n07myn4m3/Electromiografo/README.md

WIKI  
-> https://n07myn4m3.github.io/  
PAPER  
-> https://www.overleaf.com/read/nbnqfxnxsdqp
