n07myn4m3/Electromiografo/paper-electromiografo/main.tex

\documentclass[oneside]{scrbook} 

\usepackage{siunitx}
\usepackage[spanish]{babel}
\usepackage[utf8]{inputenc}
\usepackage{amsmath}
\usepackage{amssymb}
\usepackage{graphicx}
\usepackage{float}
\usepackage{hyperref}
\usepackage{varioref}
\usepackage{fancyref}
\usepackage{cleveref}
\usepackage{pgfplots}
\usepackage{changepage}  
\usepackage{subcaption}
\usepackage{amsmath}
%-----------------------------------
\usepackage[backend=bibtex]{biblatex}
\addbibresource{electro.bib}

\title{Paper electromiografo} 

\author{Nicolás Ospina Mendivelso}

\date{\today} 

\begin{document} 
\maketitle 

\tableofcontents 
\listoffigures 
\listoftables 

\include{Contexto/Contexto} 
\include{Capitulo_1/Capitulo_1} 
\include{Caracterizacion/Caracterizacion}
\include{Capitulo_2/Capitulo_2}

\printbibliography

\end{document}
