n07myn4m3/Electromiografo/Info/listMaterials.md

# Pendiente
Lista de transistores que aun no se encuentran en las librerias  
* IRF7305  
* S12301
