n07myn4m3/Electromiografo/PCB/prototypeBoard/prototypeBoard.PDF

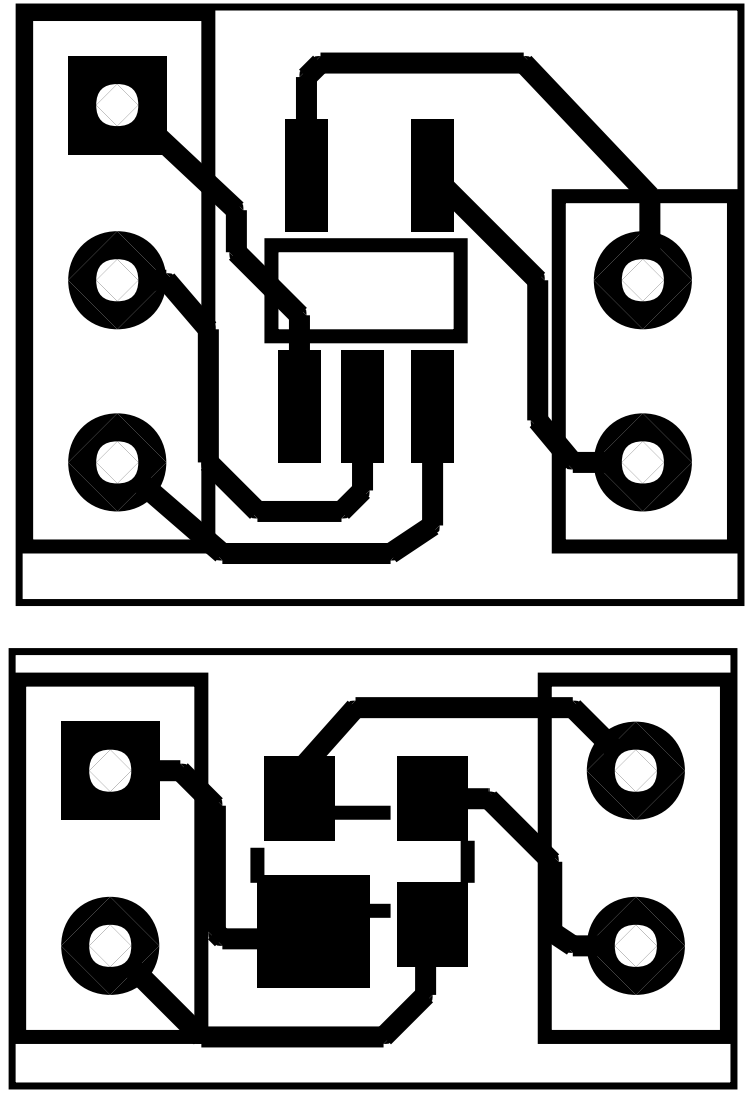
[picture p26: page 1]
