n07myn4m3/Electromiografo/Design/dif_bjt/simulacion.asc

C1: cap; 10µ
C2: cap; 10µ
Q1: npn; QS5W1
Q2: npn; QS5W1
Q3: npn; BCV61
Q4: npn; BCV61
R1: res; 15k
R2: res; 15k
R3: res; 24.9k
V1: voltage; 5
V2: voltage; 5
V3: voltage; SINE(0 0.01 1000 0 0 0)
V4: voltage; SINE(0 0.01 1000 0 0 180)
Named nets: 0, Vcc, Vee, Vin1, Vin2, Salida2, Salida1
.lib ../Componentes/BJT.txt
.tran 0 0.002 0
COMPONENTES
SIMULACION
ALIMENTACION
ENTRADAS
