n07myn4m3/Electromiografo/Design/dif_mosfet_actload/simulacion.asc

C1: cap; 1µf
M1: nmos; QS5K2
M2: nmos; QS5K2
Q1: pnp; BCV62
Q2: pnp; BCV62
Q3: npn; BCV61
Q4: npn; BCV61
R1: res; 10k
R2: res; 10k
R3: res; 30k
R4: res; 1k
V1: voltage; 5
V2: voltage; 5
V3: voltage; SINE(0 0.001 1000 0 0 0)
V4: voltage; SINE(0 0.001 1000 0 0 180)
Named nets: 0, Vcc, Vee, Vin1, Vin2
.lib ../Componentes/BJT.txt
.tran 0 0.01 0
.lib qs5k2.txt
COMPONENTES
SIMULACION
ALIMENTACION
ENTRADAS
