n07myn4m3/Electromiografo/Design/Drenador/Drenador.asc

R1: res; 100
R2: res; 100
U2: BCV61
V1: voltage; 5
Named nets: 0, Vcc
.lib ../Componentes/BCV61.lib
.tran 0.01
