n07myn4m3/Electromiografo/Design/Emiter_follower_ind/Emiter_follower_ind.asc

C1: cap; 10µ
Q1: npn; 2N3904
Q2: npn; BCV61
Q5: npn; BCV61
R3: res; 20.87k
R9: res; 1Meg
V1: voltage; 5
V2: voltage; 5
V3: voltage; SINE(0 0.015 1000 0 0 0); AC 0.015 0
Named nets: 0, Vcc, Vee, Vin1, Salida
.lib ../Componentes/BJT.txt
COMPONENTES
SIMULACION
ALIMENTACION
ENTRADAS
.tran 0 0.002 0
