n07myn4m3/Electromiografo/Design/espejo/seguidor.asc

M1: nmos; IRF7303
R3: res; 1k
V1: voltage; 5
V2: voltage; 5
V3: voltage; SINE(0 0.01 1000 0 0 0)
Named nets: 0, Vcc, Vee
.tran 0 0.01 0
.lib ../Componentes/MOSFET.txt
