n07myn4m3/Electromiografo/Design/espejo/simulacion DC.asc

I1: current; 300µ
Q1: npn; QS5W2
Q2: npn; QS5W2
Q3: npn; BCV61
Q4: npn; BCV61
R1: res; 32k
R2: res; 32k
V1: voltage; 5
V2: voltage; 5
Named nets: 0, Vcc, Vee
.lib ../Componentes/ BJT.txt
.tran 0 0.01 0
