n07myn4m3/Electromiografo/Design/espejo/simulacion.asc

Q3: npn; BCV61
Q4: npn; BCV61
R2: res; 20k
R3: res; 24.2k
V1: voltage; 5
V2: voltage; 5
Named nets: 0, Vcc, Vee
.lib ../Componentes/BJT.txt
.tran 0 0.01 0
COMPONENTES
SIMULACION
ALIMENTACION
