n07myn4m3/Electromiografo/Design/dif_mosfet/simulacion.asc

C1: cap; 22µf
M1: nmos; QS5K2
M2: nmos; QS5K2
Q3: npn; BCV61
Q4: npn; BCV61
R1: res; 15k
R2: res; 15k
R3: res; 24.2k
R4: res; 1Meg
V1: voltage; 5
V2: voltage; 5
V3: voltage; SINE(0 0.015 1000 0 0 0)
V4: voltage; SINE(0 0.015 1000 0 0 180)
Named nets: 0, Vcc, Vee, Vin1, Vin2, Salida
.lib ../Componentes/BJT.txt
.tran 0 0.002 0
.lib qs5k2.txt
COMPONENTES
SIMULACION
ALIMENTACION
ENTRADAS
