n07myn4m3/Electromiografo/Design/dif_bjt_actload/bjt_act_load.asc

C1: cap; 22µ
C2: cap; 22µ
C3: cap; 22µ
Q1: npn; QS5W1
Q2: npn; QS5W1
Q3: npn; BCV61
Q4: npn; BCV61
Q5: pnp; BCV62
Q6: pnp; BCV62
R1: res; 3MEG
R2: res; 7MEG
R3: res; 32k
R4: res; 3Meg
R5: res; 7MEG
V1: voltage; 5
V2: voltage; 5
V3: voltage; SINE(0 0.01 1000 0 0 0)
V4: voltage; SINE(0 0.01 1000 0 0 180)
Named nets: 0, Vcc, Vee, Vin1, Vin2
.lib ../Componentes/BJT.txt
.tran 0 0.01 0
COMPONENTES
SIMULACION
ALIMENTACION
ENTRADAS
