n07myn4m3/Electromiografo/Design/Emiter_follower/Emiter_follower.asc

C1: cap; 20n
M1: nmos; QS5K2
M2: nmos; QS5K2
Q1: npn; 2N3904
Q2: npn; BCV61
Q3: npn; BCV61
Q4: npn; BCV61
Q5: npn; BCV61
R1: res; 50k
R2: res; 50k
R3: res; 50k
R4: res; 100k
R5: res; 100k
R7: res; 32k
R8: res; 1Meg
R9: res; 1Meg
V1: voltage; 5
V2: voltage; 5
V3: voltage; SINE(0 0.015 1000 0 0 0); AC 0.015 0
V4: voltage; SINE(0 0.015 1000 0 0 180); AC 0.015 180
Named nets: 0, Vcc, Vee, Vin1, Vin2
.lib ../Componentes/BJT.txt
.lib qs5k2.txt
COMPONENTES
SIMULACION
ALIMENTACION
ENTRADAS
;tran 0 0.002 0
.ac oct 10 0.002 5k
