n07myn4m3/Electromiografo/Design/LTspice/Fuente.asc

R1: res; 100
R2: res; 100
U1: BCV62
V1: voltage; 5
Named nets: 0, Vcc
.lib BCV62.lib
.tran 0.01
