n07myn4m3/Electromiografo/Design/Caracterizacion/QS5K2/simulacion.asc

M1: nmos; QS5K2
R1: res; 15k
V1: voltage; 5
V2: voltage; SINE(0 0.015 1000 0 0 180)
Named nets: 0
.tran 0 0.002 0
.lib ../../Componentes\\qs5k2.txt
COMPONENTES
SIMULACION
ALIMENTACION
