n07myn4m3/Electromiografo/(list of files, drawings)

Other design files:
PCB/Amplifier/PCB final.DSN
PCB/Amplifier/PCB final.LYT
PCB/footprint4pins/PCBPROY4.LYT
PCB/footprint5Pins/footprint.LYT
PCB/prototypeBoard/prototypeBoard.LYT
