n07myn4m3/Electromiografo/(commit log)

2017-04-03 primera prueba qucs
    [circuitoprueba.sch, instru.sch]
2017-04-03 Update List materials.md
2017-04-03 Rename List materials.md to listMaterials.md
2017-04-09 datos spice y datasheets
    [espejo.sch]
2017-04-09 pruebas de simulacion de los espejos
    [circuitoprueba.sch, espejo.sch, instru.sch]
2017-04-10 las carpetas de simulacion quedaron organizadas, sin embargo existe un problema con el espejo de corriente
2017-04-23 inicio amp dif mosfet
2017-05-08 pruebas diferenciales mosfet
2017-05-27 diseños baquelas
    [PCB final.DSN, PCB final.LYT, PCB final.SDF, PCBPROY4.LYT, footprint.LYT, prototypeBoard.LYT]
2017-09-08 retomando el proyecto
